mrplants/PPE/README.md

# PPE
This repository will contain 3D printable gear required for response to the COVID-19 pandemic.

## Face Shield
Our choice for most dependable and easily printable face shield is the [prusa face shield](https://www.prusa3d.com/covid19/).  We'll keep this repo updated with the newest version.
