mrplants/PPE/prusa-protective-face-shield-rc3-model_files/25857-prusa-protective-face-shield-rc3-482636d6-c70f-49cf-be1a-cffca3aa87dc.pdf

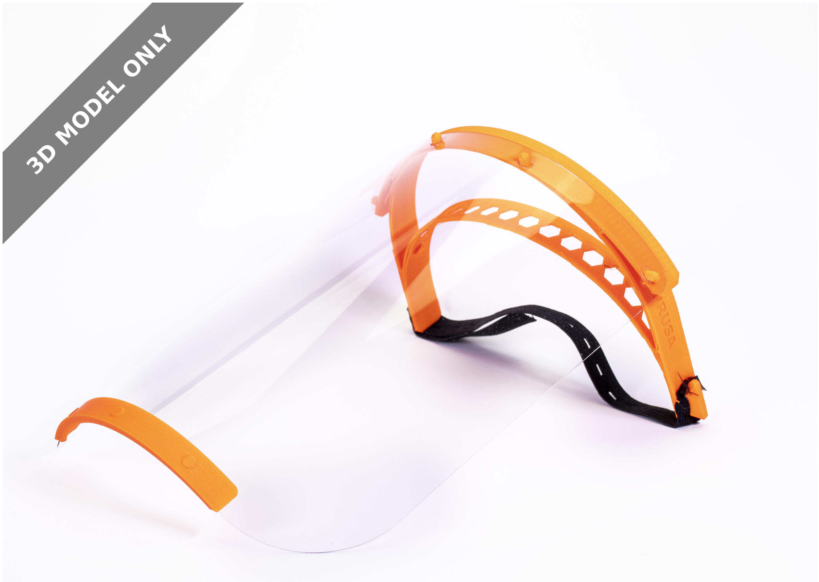
[picture p1: figure]
3D MODEL ONLY

## Summary

A prototype face shield that we developed. In three days, we went through dozens of prototypes and two verifications with the Czech Ministry of Health.

Check this print (https://www.prusaprinters.org/prints/27267) for stacked versions (1h 20min per pcs).

Update - we've added groups to PrusaPrinters Learn how to coordinate on (not only) the protective face shields printing in our article (https://blog.prusaprinters.org/how-to-coordinate-not-only-producing-of-protective-face-shields-via-prusaprinters-groups/) Discover groups near you (https://www.prusaprinters.org/group/discover)

Version RC3 changelog Changes from RC2:

Removed hexagonal holes for faster printing speeds
With faster printing we use on our farm, some pieces had sharp points and based on testing, the venting is not needed as much Several optimizations for stack printing
New print files with 4 headbands stacked (https://www.prusaprinters.org/prints/27267) on top of each other Stacking headbands is a great idea by the community, especially useful for overnight printing

Prusa Research (https://www.prusaprinters.org/social/16/prints)

## Prusa Protective Face Shield - RC3

VIEW IN BROWSER (https://www.prusaprinters.org/prints/25857-prusa-protective-face-shield-rc3)

updated 30. 3. 2020 | published 26. 3. 2020

•
◦

•
•
◦

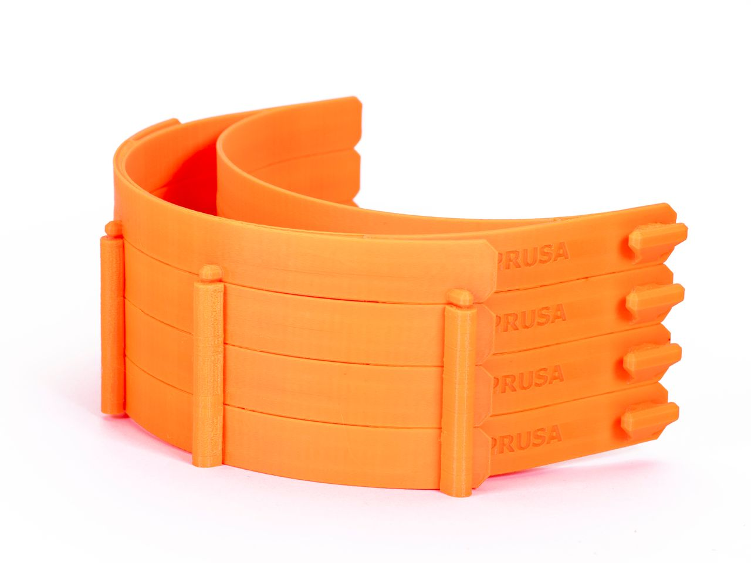
[picture p2: figure]

Version RC2 Changes from RC1:

Increased wall thickness (slightly stiffer and more durable)
Inner wall from 1.5 mm to 2 mm
Outer wall from 2 mm to 2.5 mm
The headband is no longer printed compressed - Lower pressure on the temple
The visor was moved further away from the forehead - This allows a better fit over bigger respirators and protective goggles
The printed part now has an extension for the visor (the visor curves less than the headband).

For now, both RC1 and RC2 versions are relevant. RC1 lets you fit more printed parts on a single print bed. However, if maximum yield isn’t the priority, RC2 provides slightly better protection and is more comfortable to

•
◦
◦
•

•

•

wear.


If you want to manufacture shields for others PLEASE READ THIS CAREFULLY

Act as if you were infected by the COVID-19 virus. Wear a face mask and a fresh pair of gloves when collecting each batch of printed parts. Store the parts immediately in a sealable bag.
Talk with whoever you’re making the shields for, let them know about your manufacturing environment
There is still debate about how long the virus survives on plastic, but most sources mention 2-3 days. That means that by letting the packed face shields sit for 2-3 days before distributing them, you’ll greatly reduce risk of transmission
Do not store the entire stock in one place, minimize the risk of cross contamination

More information: https://blog.prusaprinters.org/from-design-to-mass-3d-printing-of-medical-shields-in-three-days/ (https://blog.prusaprinters.org/from-design-to-mass-3d-printing-of-medical-shields-in-three-days/)

How to STERILIZE the face shields Sterilization guide (https://help.prusa3d.com/en/article/prusa-face-shield-disinfection_125457) We have tests with live COVID running to verify as many of these sterilization methods as possible.

Assembly manual: English version (https://manual.prusa3d.com/Guide/Prusa+Face+Shield/1527) English Community version using a laminating foil (https://manual.prusa3d.com/Guide/Assembling+the+Prusa+Face+Shield+-+community+version/1528#s41280) Czech version (https://manual.prusa3d.com/Guide/Prusa+Oblicejovy+Stit/1526)

Video:

"https://www.youtube.com/embed/pP7z3iw76GA"

Rubber band You can either use a thicker one and make a hole in it at each end (make at least 10 mm cut) or use a thin one and tie it to both ends of the shield.

•

•

•

•

Visor / front plate

there is a DXF drawing in the file section (and an alternative longer version)
the holes can be made with a standard office hole puncher
we used 0.5 mm thick petg sheet (Covestro VIVAK), but you should be able to use any clear laser cuttable plastic with similar thickness.

Visor PDF drawings Normal size (http://prusa3d.com/downloads/others/COVID19_SHIELD_FOIL.pdf) Extended version (dentists) (http://prusa3d.com/downloads/others/COVID19_SHIELD_FOIL_LONG.pdf)

Top cover for the headband A cover for the headband, (https://www.prusaprinters.org/prints/27318-prusa-protective-face-shield-cover-rc1-wip) which is useful for very high-risk environments as they provide even better protection.

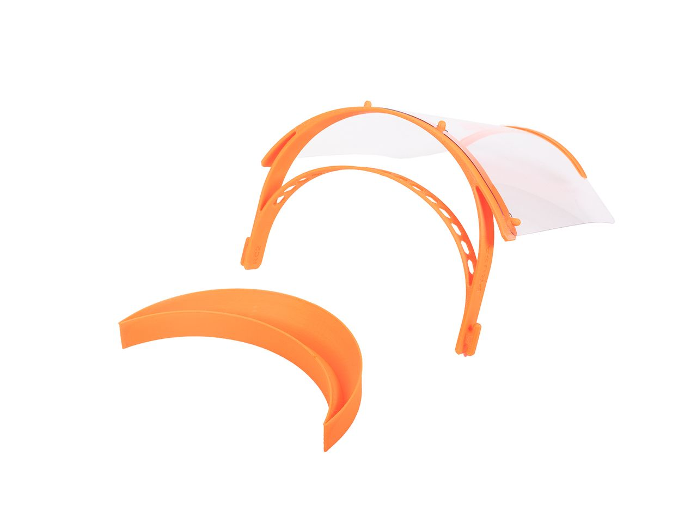
[picture p4: figure]

Fast print files for 4 stacked RC3 headbands If you own an Original Prusa printer, you can use our Speed optimized print files for the RC3 stacked version (1h 20min per pcs). (https://www.prusaprinters.org/prints/27267-prusa-protective-face-shield-rc31-stack-versions)

Licence and selling of face shields We share these files under non-commercial licence. It would be great if you donated these shields to those in need for free. If you need to cover your production costs, we are ok with you selling the shields for production cost. However, we do not want to see these shields on eBay for $50.

Healthcare (https://www.prusaprinters.org/prints?categoryId=87) > Accessibility (https://www.prusaprinters.org/prints?categoryId=88)

•

•
•

Model Files (.stl, .3mf, .obj, .amf) | DOWNLOAD ALL FILES (https://www.prusaprinters.org/prints/25857-prusa-protective-face-shield-rc3/files)

354.1 KB
updated 26. 3. 2020 | (https://www.prusaprinters.org/prints/25857-prusa-protective-face-shield-rc3/files)

729.6 KB
updated 26. 3. 2020 | (https://www.prusaprinters.org/prints/25857-prusa-protective-face-shield-rc3/files)

873.8 KB
updated 26. 3. 2020 | (https://www.prusaprinters.org/prints/25857-prusa-protective-face-shield-rc3/files)

290.5 KB
updated 27. 3. 2020 | (https://www.prusaprinters.org/prints/25857-prusa-protective-face-shield-rc3/files)

287.6 KB
updated 27. 3. 2020 | (https://www.prusaprinters.org/prints/25857-prusa-protective-face-shield-rc3/files)

662.6 KB
updated 27. 3. 2020 | (https://www.prusaprinters.org/prints/25857-prusa-protective-face-shield-rc3/files)

975.6 KB
updated 27. 3. 2020 | (https://www.prusaprinters.org/prints/25857-prusa-protective-face-shield-rc3/files)

Supports are not necessary. Print with at least 3 perimeters, about 30% infill.

Ideally, print it from PETG.

covid19_headband_rc3_1pcs.3mf

covid19_headband_rc3.stl

covid19_headband_rc3.stp

covid19_headband_rc2_1pcs.3mf

covid19_headband_rc2_2pcs.3mf

covid19_headband_rc2.stl

covid19_shield_rc2.stp

284.2 KB
updated 27. 3. 2020 | (https://www.prusaprinters.org/prints/25857-prusa-protective-face-shield-rc3/files)

585.1 KB
updated 27. 3. 2020 | (https://www.prusaprinters.org/prints/25857-prusa-protective-face-shield-rc3/files)

841.8 KB
updated 27. 3. 2020 | (https://www.prusaprinters.org/prints/25857-prusa-protective-face-shield-rc3/files)

383.1 KB
updated 27. 3. 2020 | (https://www.prusaprinters.org/prints/25857-prusa-protective-face-shield-rc3/files)

321.6 KB
updated 27. 3. 2020 | (https://www.prusaprinters.org/prints/25857-prusa-protective-face-shield-rc3/files)

3.8 KB
updated 27. 3. 2020 | (https://www.prusaprinters.org/prints/25857-prusa-protective-face-shield-rc3/files)

300.2 KB
updated 27. 3. 2020 | (https://www.prusaprinters.org/prints/25857-prusa-protective-face-shield-rc3/files)
- The Author has not uploaded any print files. Try to search in User print files (https://www.prusaprinters.org/prints/25857-prusa-protective-face-shield-rc3/user-gcodes) section or generate and upload your own.

covid19-shield.3mf

covid19_headband_rc1.stl

covid19_shiled_r1.stp

bottom_reinforcement.stl

bottom_reinforcement.step

shield_final.dxf

shield_longer_version.dxf

## License

This work is licensed under a
Creative Commons (4.0 International License)

Attribution-NonCommercial (http://creativecommons.org/licenses/by-nc/4.0/)

✖ | Sharing without ATTRIBUTION
✔ | Remix Culture allowed
✖ | Commercial Use
✖ | Free Cultural Works
✖ | Meets Open Definition
