mrplants/PPE/prusa-protective-face-shield-rc3-model_files/RC3.1 (stackable)/Stacked Models/27267-prusa-protective-face-shield-rc31-stack-versions-3ac5c21a-b8bc-48b3-9df8-82bd31b9710d.pdf

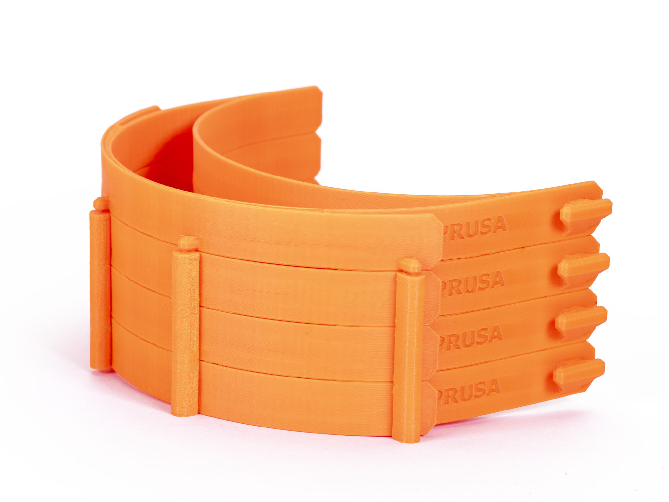
[picture p5: figure]

16.42 hrs

2 pcs

f

0.25 mm

k

0.40 mm

h

8

540.00 g

d

MK3/S

## Summary

1h 20min per pcs

Stacking versions of Prusa Protective Face Shield - RC3 (https://www.prusaprinters.org/prints/25857)

A prototype face shield that we developed. In three days, we went through dozens of prototypes and two verifications with the Czech Ministry of Health.

Provided G-codes are only for Original Prusa i3 MK3/S printers. Do not run the G-codes on other printers. Risk of damage.

We provided two options, including reinforcement parts:

4 pcs on the print bed (2 stacks, each with 2 headbands) 8 pcs on the print bed (2 stacks, each with 4 headbands)

Version RC3.1 changelog Changes from RC3

Fixed missing supports under two pins in the second headband

The printer will be running at increased speeds. Expect louder operation and make sure your printer is in good shape before running this G-code. Check the Maintenance guide. (https://help.prusa3d.com/en/article/i3-printers-regular-maintenance_2072)

Prusa Research (https://www.prusaprinters.org/social/16/prints)

## Prusa Protective Face Shield - RC3.1 - stack versions

VIEW IN BROWSER (https://www.prusaprinters.org/prints/27267-prusa-protective-face-shield-rc31-stack-versions)

updated 31. 3. 2020 | published 27. 3. 2020

•
•

•

Print Files (.gcode) | DOWNLOAD ALL FILES (https://www.prusaprinters.org/prints/27267-prusa-protective-face-shield-rc31-stack-versions/files)

17.7 MB

- 5.31 hrs f 0.25 mm k 0.40 mm h PET | 179.00 g
updated 27. 3. 2020 | (https://www.prusaprinters.org/prints/27267-prusa-protective-face-shield-rc31-stack-versions/files)

36.6 MB

- 11.11 hrs f 0.25 mm k 0.40 mm h PET | 361.10 g
updated 27. 3. 2020 | (https://www.prusaprinters.org/prints/27267-prusa-protective-face-shield-rc31-stack-versions/files)
Model Files (.stl, .3mf, .obj, .amf) | DOWNLOAD ALL FILES (https://www.prusaprinters.org/prints/27267-prusa-protective-face-shield-rc31-stack-versions/files)

479.4 KB
updated 27. 3. 2020 | (https://www.prusaprinters.org/prints/27267-prusa-protective-face-shield-rc31-stack-versions/files)

Healthcare (https://www.prusaprinters.org/prints?categoryId=87) > Accessibility (https://www.prusaprinters.org/prints?categoryId=88)

Supports are included in the model. Print with at least 2 perimeters, and 5% infill. The model is optimized for a layer height of 0.25mm.

Print it from PETG, headbands from other material can be brittle with these print settings.

## This remix is based on

Prusa Protective Face Shield - RC3 (https://www.prusaprinters.org/prints/25857-prusa-protective-face-shield-rc3) by Prusa Research (https://www.prusaprinters.org/social/16/prints)

covid19_rc31_4pcs_complete_025mm_pet__5h19m_mk3.gc (https://www.prusaprinters.org/prints/27267-prusa-protective-face-shield-rc31-stack-versions/files)

covid19_rc31_8pcs_complete_025mm_pet__11h6m_mk3.gc (https://www.prusaprinters.org/prints/27267-prusa-protective-face-shield-rc31-stack-versions/files)

covid19_rc31_4pcs_complete.3mf

1.6 MB
updated 27. 3. 2020 | (https://www.prusaprinters.org/prints/27267-prusa-protective-face-shield-rc31-stack-versions/files)

894.5 KB
updated 27. 3. 2020 | (https://www.prusaprinters.org/prints/27267-prusa-protective-face-shield-rc31-stack-versions/files)

3.9 MB
updated 27. 3. 2020 | (https://www.prusaprinters.org/prints/27267-prusa-protective-face-shield-rc31-stack-versions/files)

## License

This work is licensed under a
Creative Commons (4.0 International License)

Attribution-NonCommercial (http://creativecommons.org/licenses/by-nc/4.0/)

✖ | Sharing without ATTRIBUTION
✔ | Remix Culture allowed
✖ | Commercial Use
✖ | Free Cultural Works
✖ | Meets Open Definition

covid19_headband_double_rc31.stl

covid19_rc31_8pcs_complete.3mf

covid19_headband_quadro_rc31.stl
