mrplants/PPE/prusa-protective-face-shield-rc3-model_files/RC3.1 (stackable)/Stacked Models/covid19_rc31_4pcs_complete.3mf

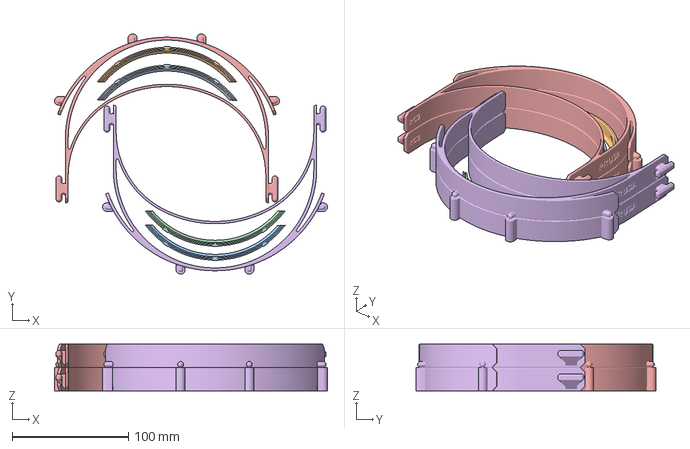
[picture p6: CAD file, 2020-04-01]
prusa-protective-face-shield-rc3-model_files/RC3.1 (stackable)/Stacked Models/covid19_rc31_4pcs_complete.3mf
234.9 x 206.8 x 40.2 mm
reinforcement_final.stl
covid19_headband_double_rc31.stl
