mrplants/PPE/prusa-protective-face-shield-rc3-model_files/RC3.1 (stackable)/Stacked Models/covid19_rc31_8pcs_complete.3mf

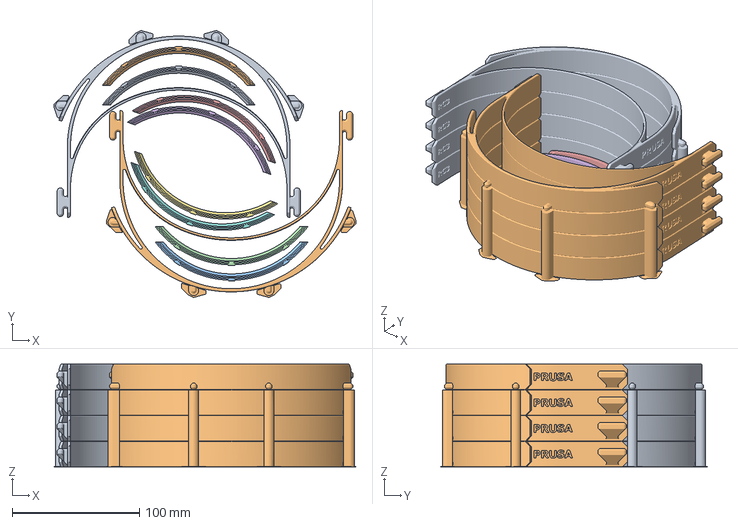
[picture p7: CAD file, 2020-04-01]
prusa-protective-face-shield-rc3-model_files/RC3.1 (stackable)/Stacked Models/covid19_rc31_8pcs_complete.3mf
237.3 x 209.5 x 80.8 mm
reinforcement_final.stl
covid19_headband_quadro_rc31.stl
