mrplants/PPE/prusa-protective-face-shield-rc3-model_files/RC1/covid19-shield.3mf

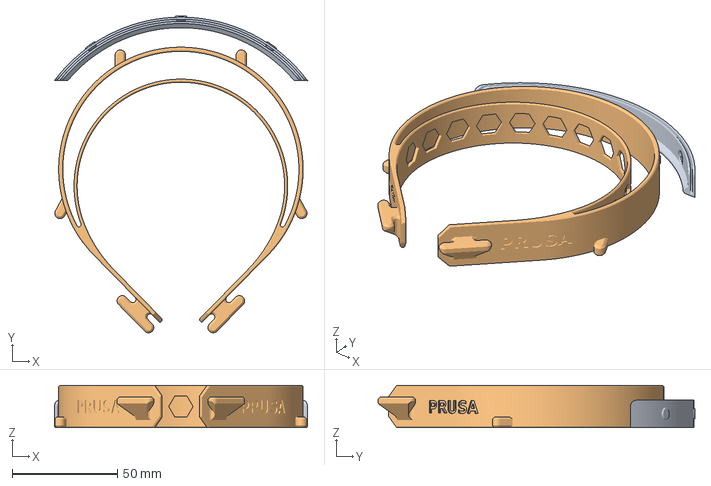
[picture p8: CAD file, 2020-03-31]
prusa-protective-face-shield-rc3-model_files/RC1/covid19-shield.3mf
120.1 x 150.3 x 20.0 mm
reinforcement_final.stl
COVID19_SHILED_R1 (1).stl
