mrplants/PPE/prusa-protective-face-shield-rc3-model_files/RC2/covid19_headband_rc2.stl

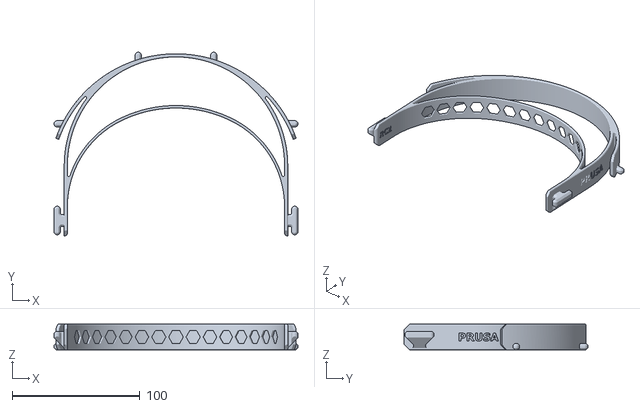
[picture p9: CAD file, 2020-03-31]
prusa-protective-face-shield-rc3-model_files/RC2/covid19_headband_rc2.stl
191.0 x 143.8 x 20.0
