mrplants/PPE/prusa-protective-face-shield-rc3-model_files/RC3/covid19_headband_rc3.stp

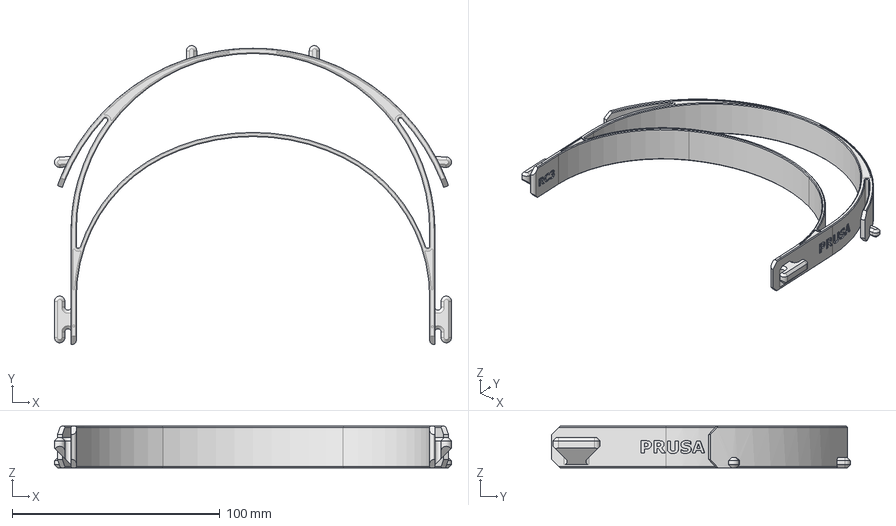
[picture p10: CAD file, 2020-03-31]
prusa-protective-face-shield-rc3-model_files/RC3/covid19_headband_rc3.stp
191.0 x 143.8 x 20.0 mm
