mrplants/PPE/prusa-protective-face-shield-rc3-model_files/RC1/shield_longer_version.dxf

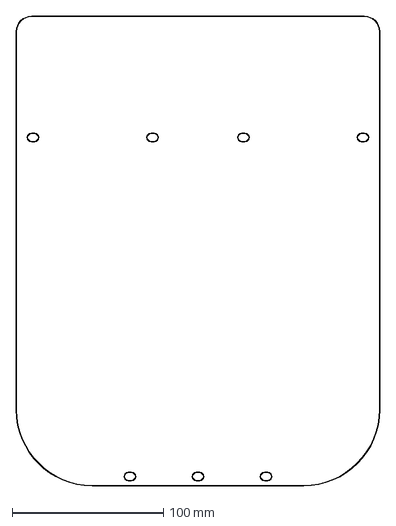
[picture p11: CAD file, 2020-03-31]
prusa-protective-face-shield-rc3-model_files/RC1/shield_longer_version.dxf
240.0 x 310.0 mm
