mrplants/PPE/prusa-protective-face-shield-rc3-model_files/RC1/covid19_headband_rc1.stl

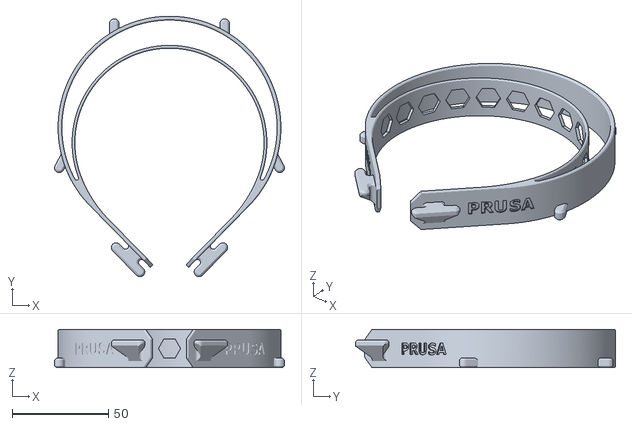
[picture p14: CAD file, 2020-03-31]
prusa-protective-face-shield-rc3-model_files/RC1/covid19_headband_rc1.stl
119.7 x 135.6 x 20.0
