mrplants/PPE/prusa-protective-face-shield-rc3-model_files/RC3.1 (stackable)/Stacked Models/covid19_headband_double_rc31.stl

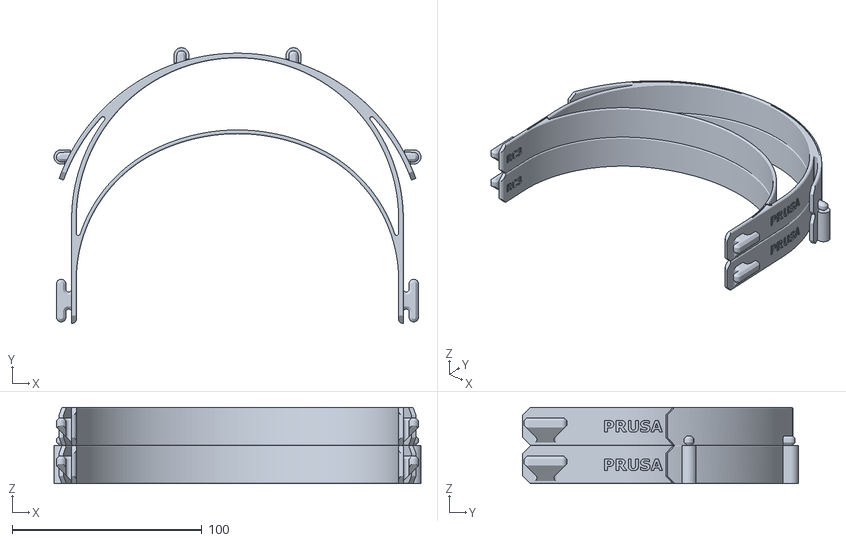
[picture p15: CAD file, 2020-04-01]
prusa-protective-face-shield-rc3-model_files/RC3.1 (stackable)/Stacked Models/covid19_headband_double_rc31.stl
193.6 x 145.4 x 40.2
