mrplants/PPE/prusa-protective-face-shield-rc3-model_files/RC1/bottom_reinforcement.step

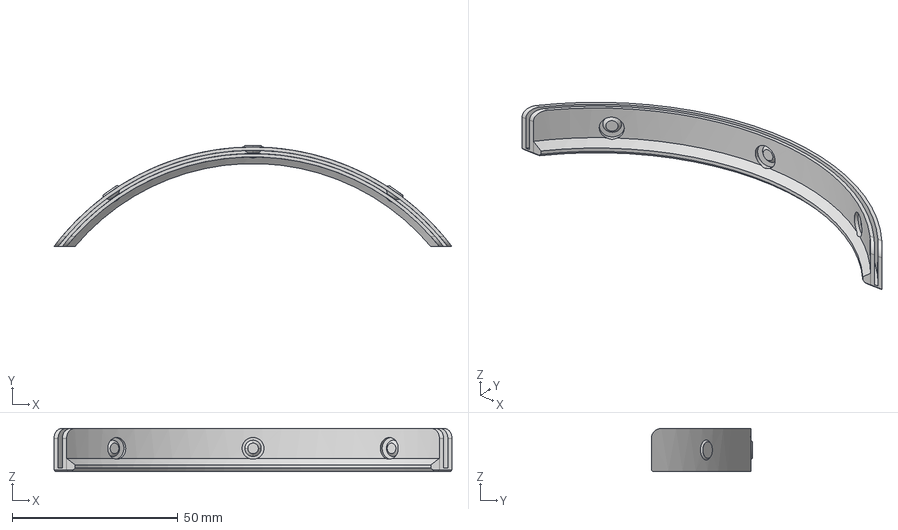
[picture p16: CAD file, 2020-03-31]
prusa-protective-face-shield-rc3-model_files/RC1/bottom_reinforcement.step
120.1 x 30.6 x 13.0 mm
