mrplants/PPE/prusa-protective-face-shield-rc3-model_files/RC2/covid19_headband_rc2_2pcs.3mf

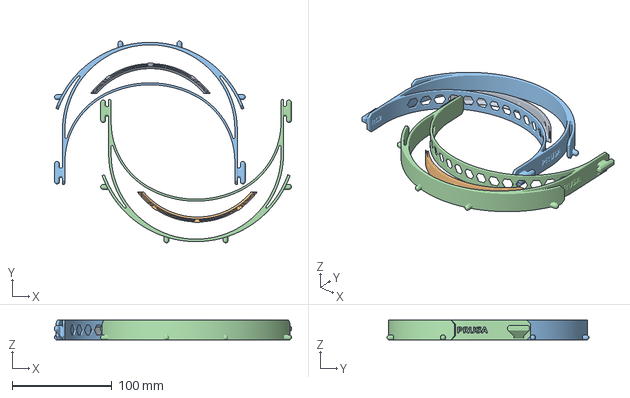
[picture p17: CAD file, 2020-03-31]
prusa-protective-face-shield-rc3-model_files/RC2/covid19_headband_rc2_2pcs.3mf
237.2 x 202.0 x 20.0 mm
reinforcement_final.stl
COVID19_SHIELD_RC2.stl
