mrplants/PPE/prusa-protective-face-shield-rc3-model_files/RC3.1 (stackable)/Stacked Models/covid19_headband_quadro_rc31.stl

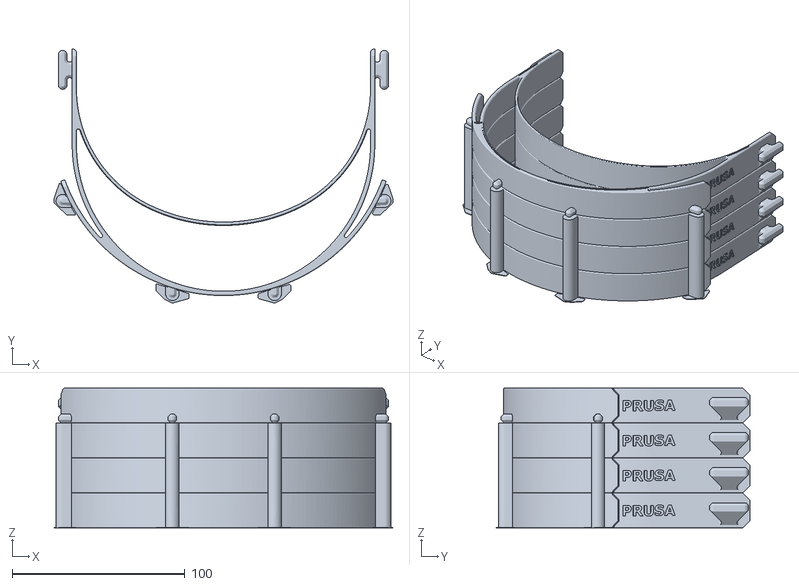
[picture p18: CAD file, 2020-04-01]
prusa-protective-face-shield-rc3-model_files/RC3.1 (stackable)/Stacked Models/covid19_headband_quadro_rc31.stl
196.0 x 146.8 x 80.8
