mrplants/PPE/prusa-protective-face-shield-rc3-model_files/RC1/shield_final.dxf

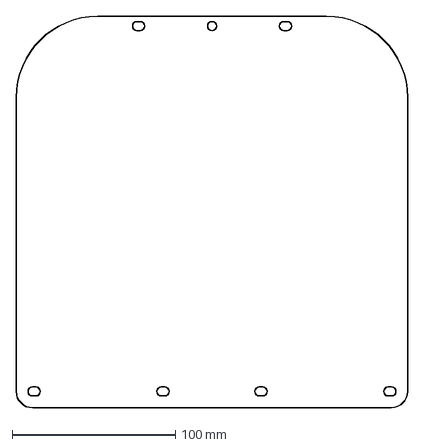
[picture p19: CAD file, 2020-03-31]
prusa-protective-face-shield-rc3-model_files/RC1/shield_final.dxf
240.0 x 240.0 mm
