mrplants/PPE/(list of files, cad)

Other CAD files:
prusa-protective-face-shield-rc3-model_files/RC2/covid19_shield_rc2.stp
prusa-protective-face-shield-rc3-model_files/RC1/covid19_shiled_r1.stp
prusa-protective-face-shield-rc3-model_files/RC1/bottom_reinforcement.stl
prusa-protective-face-shield-rc3-model_files/RC3/covid19_headband_rc3.stl
