mrplants/PPE/(commit log)

2020-03-31 adding most recent version of prusa protective face shield
    [bottom_reinforcement.step, bottom_reinforcement.stl, covid19-shield.3mf, covid19_headband_rc1.stl, covid19_headband_rc2.stl, covid19_headband_rc2_1pcs.3mf, covid19_headband_rc2_2pcs.3mf, covid19_headband_rc3.stl]
2020-03-31 added stackable models and structure to the prusa face shield models
    [bottom_reinforcement.step, bottom_reinforcement.stl, covid19-shield.3mf, covid19_headband_rc1.stl, covid19_headband_rc2.stl, covid19_headband_rc2_1pcs.3mf, covid19_headband_rc2_2pcs.3mf, covid19_headband_rc3.stl]
